32blit/32blit-hardware/README.md

# 32Blit Hardware

This repository includes the schematic and STM32 Cube files for the 32Blit console.
