32blit/32blit-hardware/mechanical/top.stp

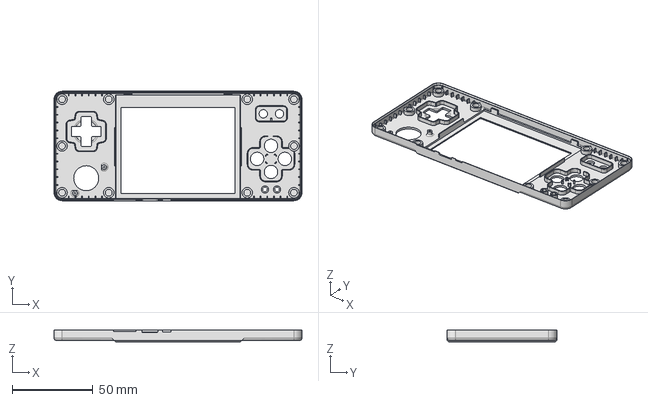
[picture p1: CAD file, 2023-02-23]
mechanical/top.stp
154.0 x 68.0 x 7.20 mm
