32blit/32blit-hardware/mechanical/action-button.stp

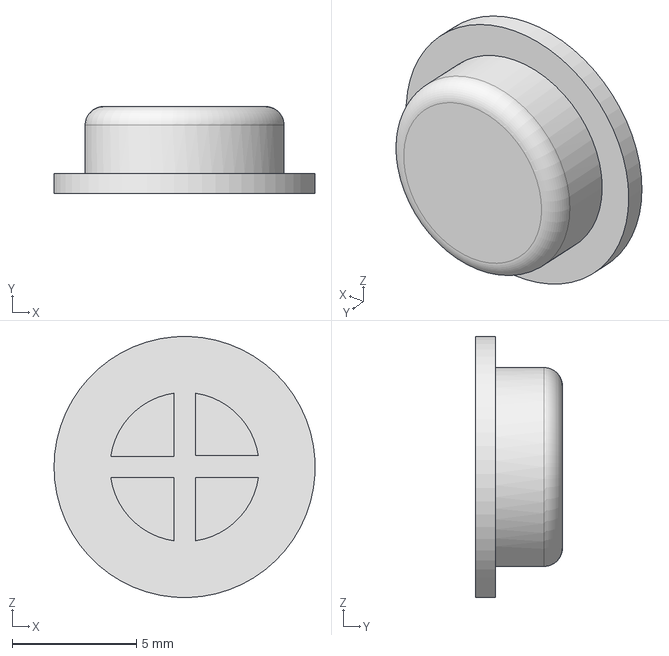
[picture p2: CAD file, 2023-02-23]
mechanical/action-button.stp
10.5 x 3.50 x 10.5 mm
