32blit/32blit-hardware/mechanical/base.stp

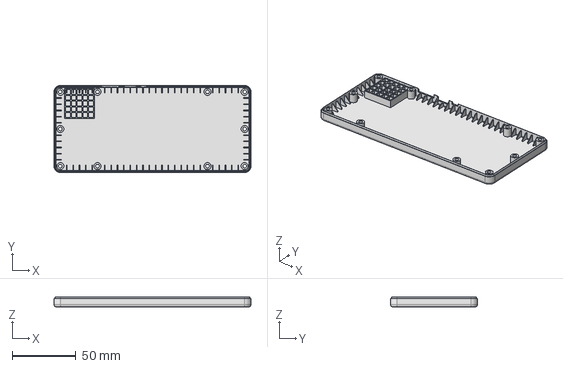
[picture p3: CAD file, 2023-02-23]
mechanical/base.stp
154.0 x 68.0 x 7.75 mm
