32blit/32blit-hardware/mechanical/system-buttons.stp

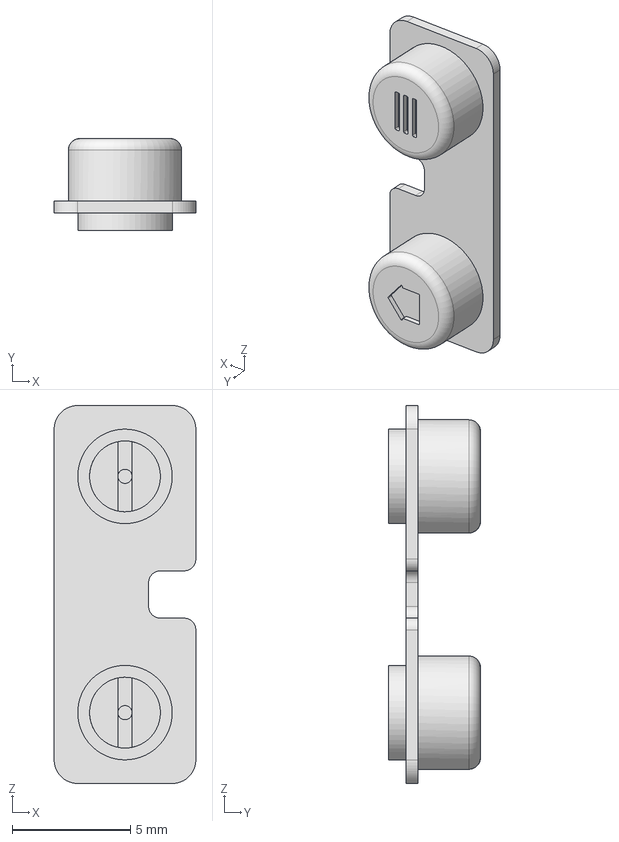
[picture p4: CAD file, 2023-02-23]
mechanical/system-buttons.stp
6.00 x 3.90 x 16.0 mm
