32blit/32blit-hardware/(list of files, cad)

Other CAD files:
mechanical/32blit.iam
mechanical/action-button.ipt
mechanical/base.ipt
mechanical/dpad.ipt
mechanical/pcb.ipt
mechanical/system-buttons.ipt
mechanical/top.ipt
