32blit/32blit-hardware/(threads)

Thread 1 (2023-01-02):

Will the Gerber files be available?

cmcknight, 2023-01-02:
Greetings!

I am wondering if the Gerber files will also be made available for this project.

Gadgetoid, 2023-02-23:
Not a Gerber, unfortunately, but the Eagle board files are now available here: https://github.com/32blit/32blit-hardware/tree/master/pcb

And mechanical design files here: https://github.com/32blit/32blit-hardware/tree/master/mechanical

Though if you're making PCBs somehow and want a case or two, I'm sure that can be arranged.

cmcknight, 2023-02-23:
Thanks Philip,

I’ll share that with my son. He’s buried with mid-terms right now but I’m sure he’ll be interested in cases if he chooses to proceed. :-)

Best regards,

Charles

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
