32blit/32blit-hardware/32blit.pdf

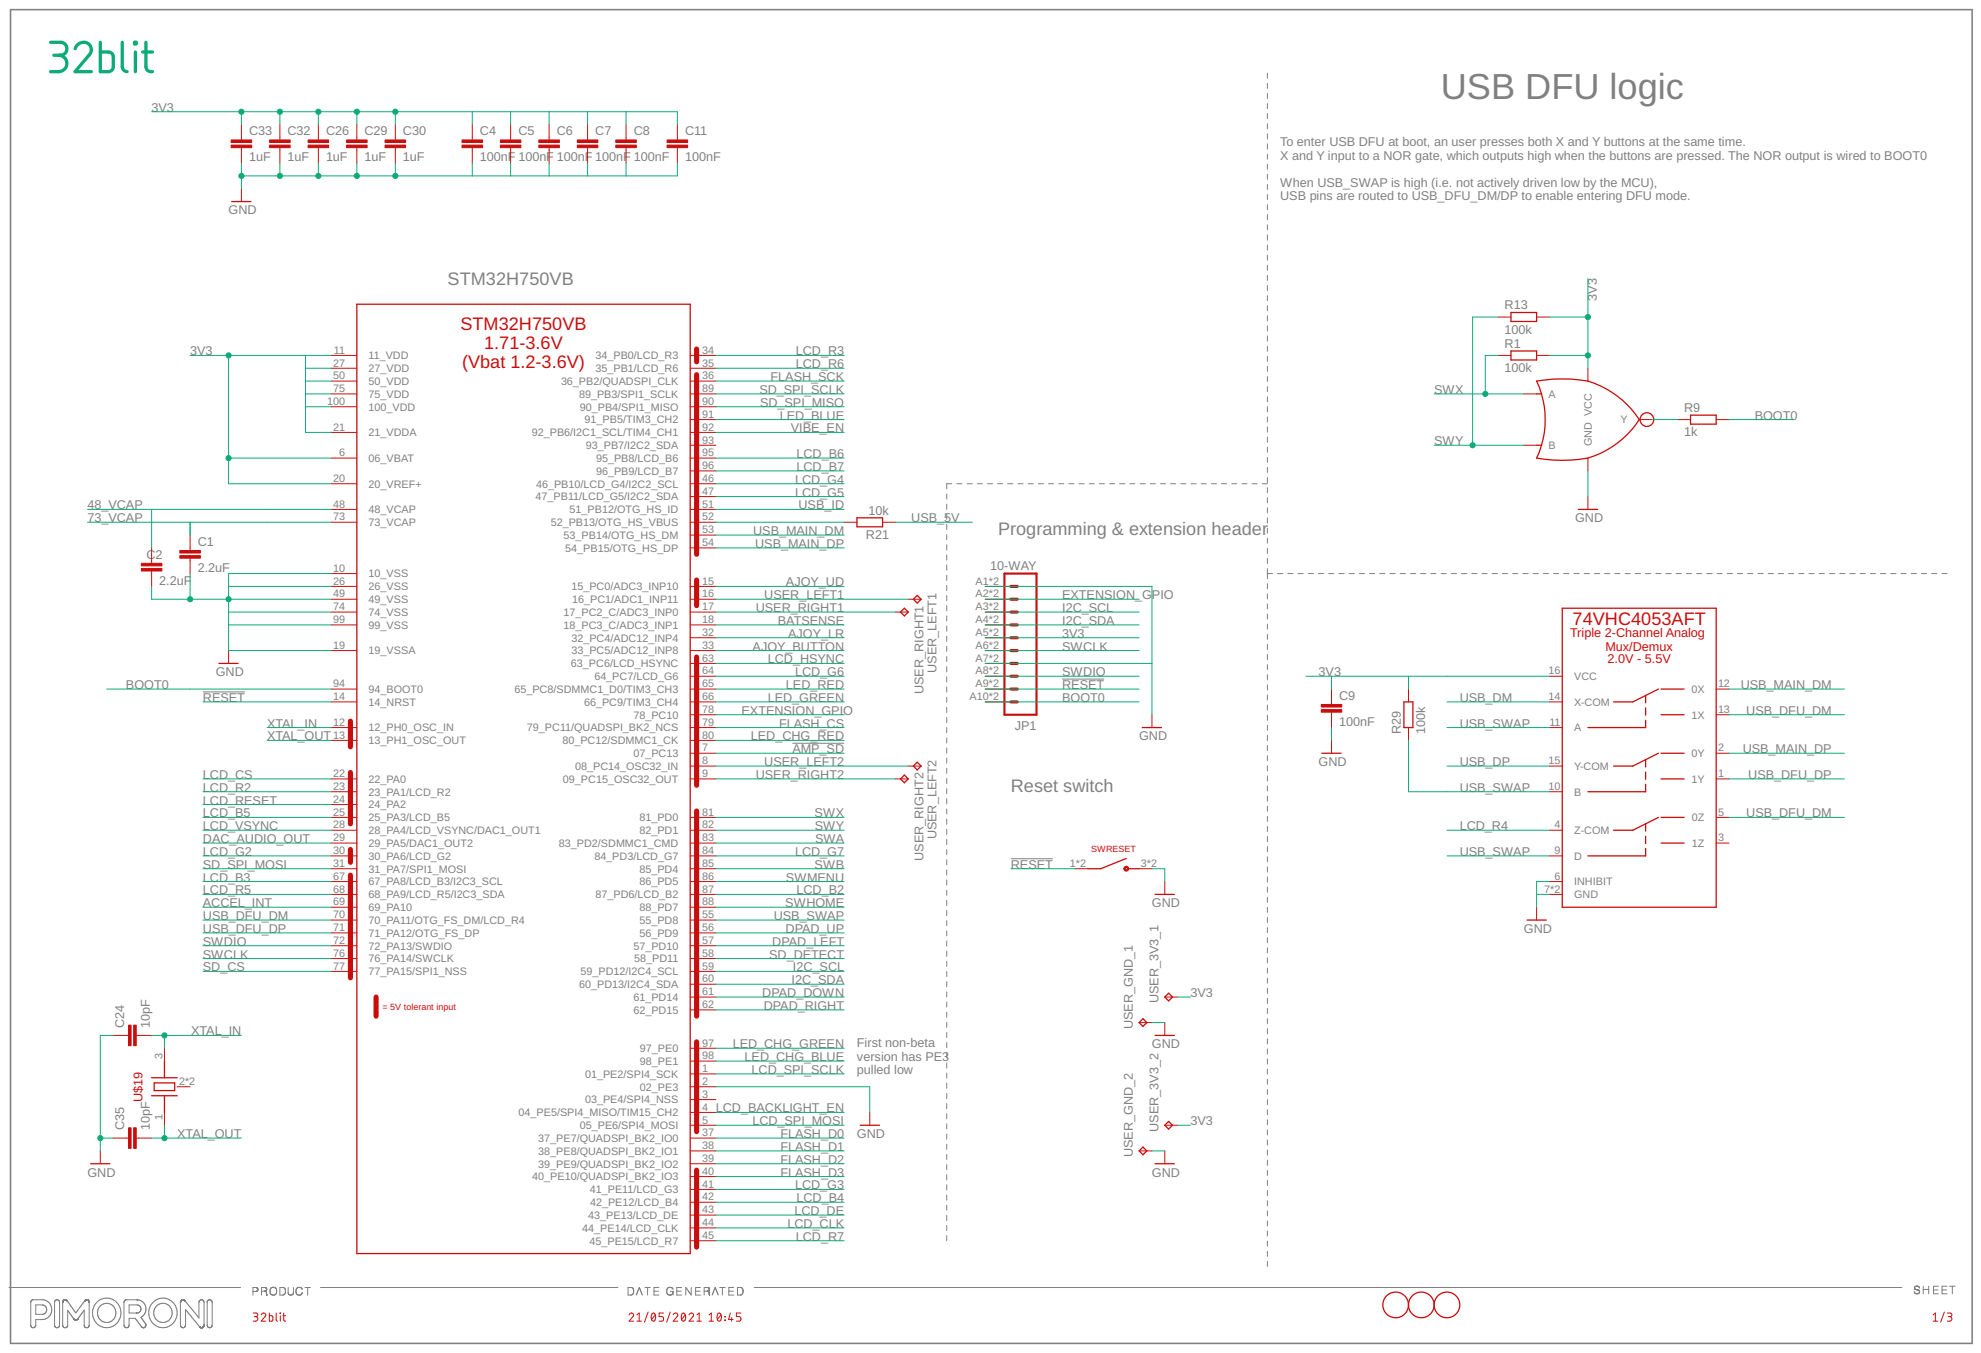
[picture p5: page 1]

To enter USB DFU at boot, an user presses both X and Y buttons at the same time. X and Y input to a NOR gate, which outputs high when the buttons are pressed. The NOR output is wired to BOOT0 When USB_SWAP is high (i.e. not actively driven low by the MCU), USB pins are routed to USB_DFU_DM/DP to enable entering DFU mode. USB DFU logic

74VHC4053AFT
Triple 2-Channel Analog Mux/Demux 2.0V - 5.5V

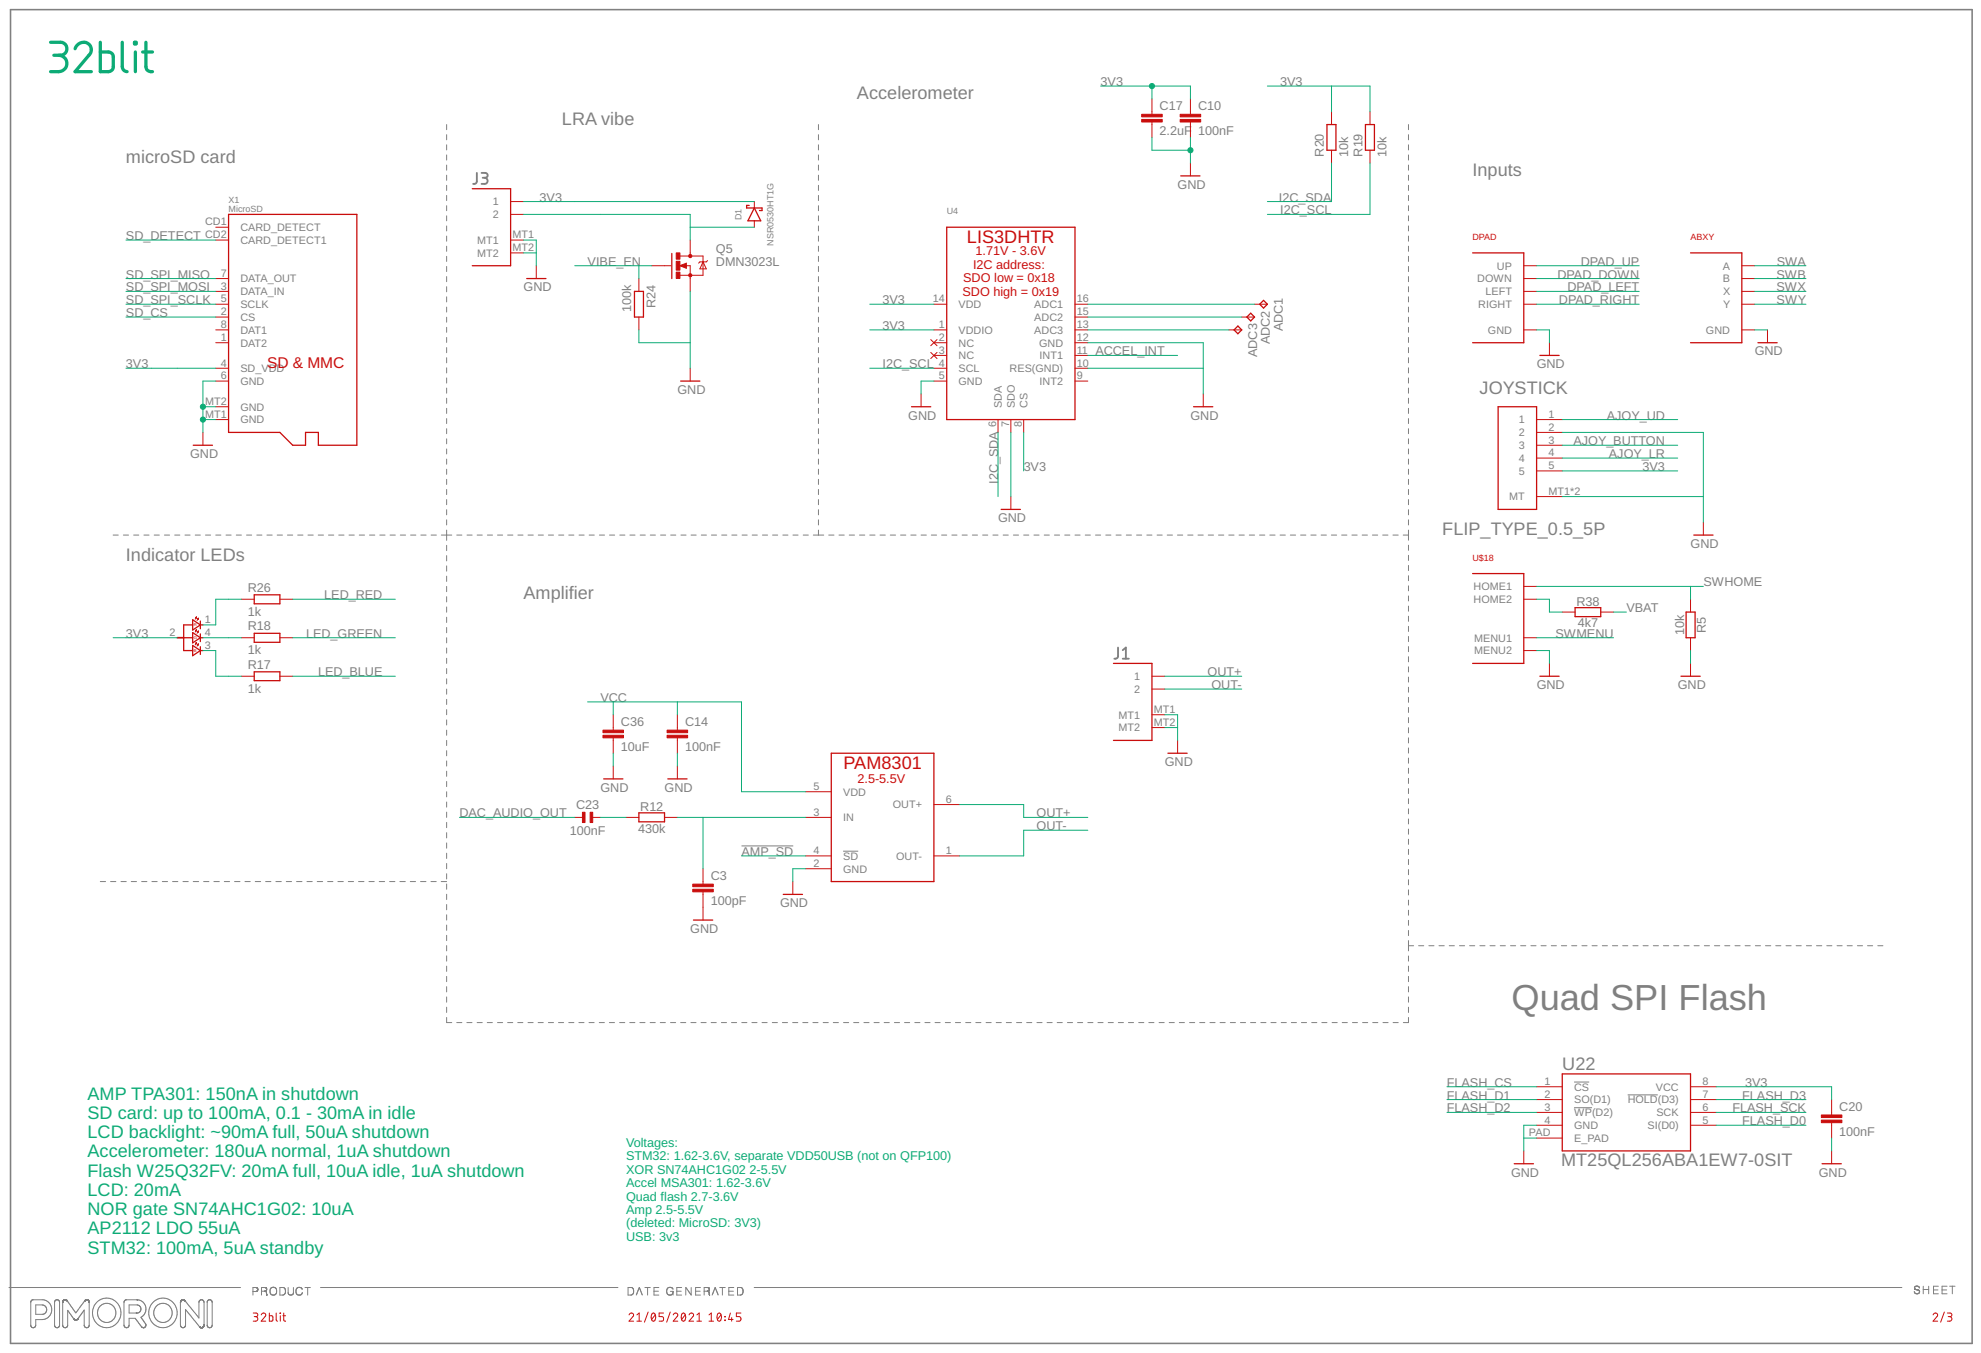
[picture p6: page 2]

LRA vibe microSD card

AMP TPA301: 150nA in shutdown SD card: up to 100mA, 0.1 - 30mA in idle

LCD backlight: ~90mA full, 50uA shutdown Accelerometer: 180uA normal, 1uA shutdown Flash W25Q32FV: 20mA full, 10uA idle, 1uA shutdown

Voltages: STM32: 1.62-3.6V, separate VDD50USB (not on QFP100) XOR SN74AHC1G02 2-5.5V

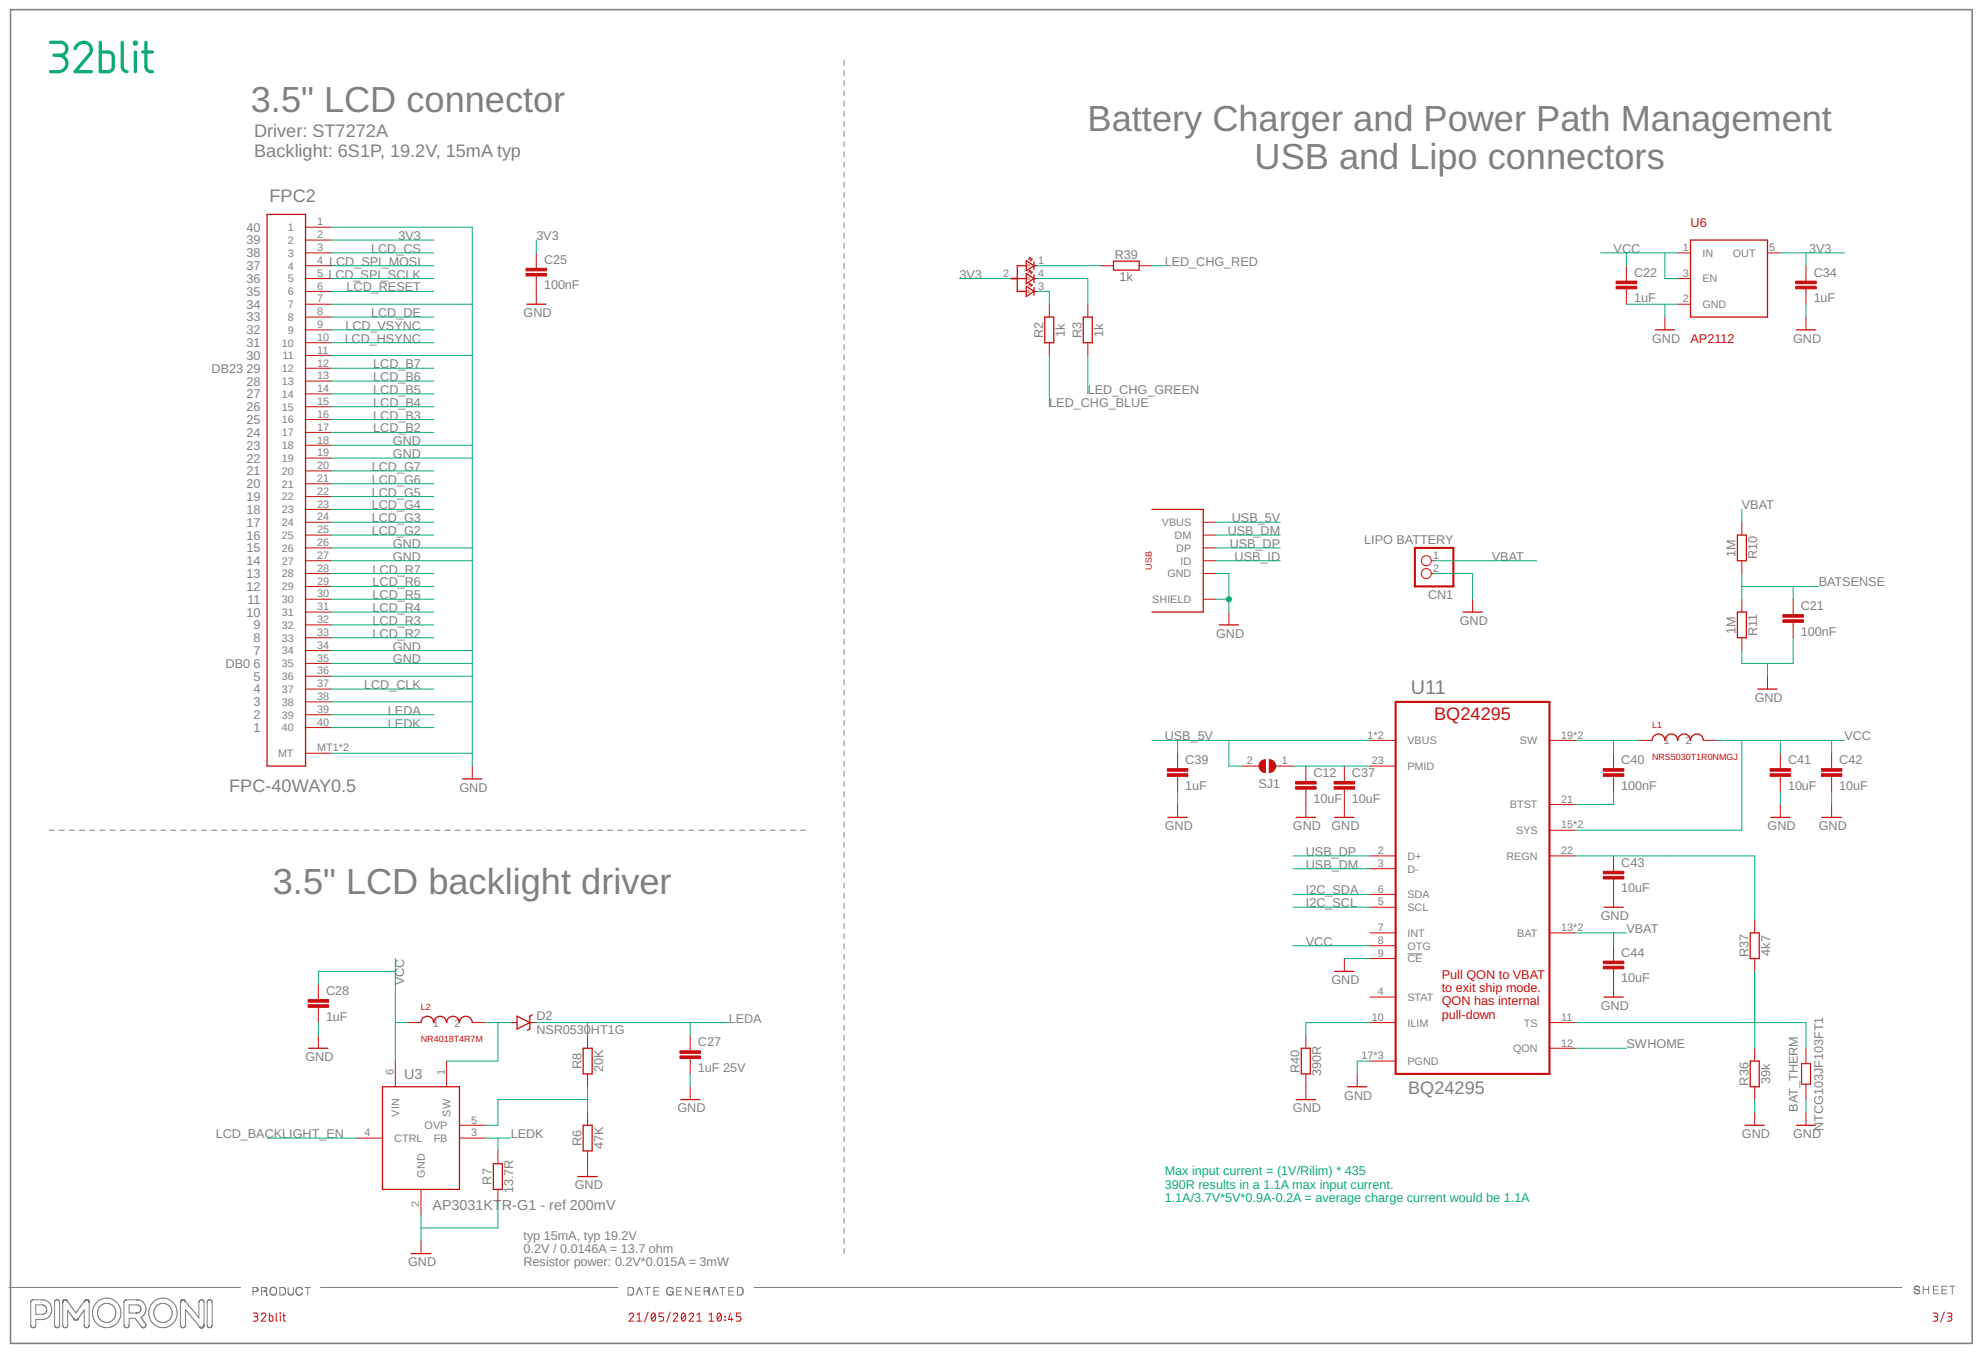
[picture p7: page 3]

Battery Charger and Power Path Management

USB and Lipo connectors

Pull QON to VBAT
to exit ship mode. QON has internal pull-down

Max input current = (1V/Rilim) * 435
390R results in a 1.1A max input current. 1.1A/3.7V*5V*0.9A-0.2A = average charge current would be 1.1A
