32blit/32blit-hardware/pcb/32blit.brd

## EAGLE design pcb/32blit.brd (2023-02-23)

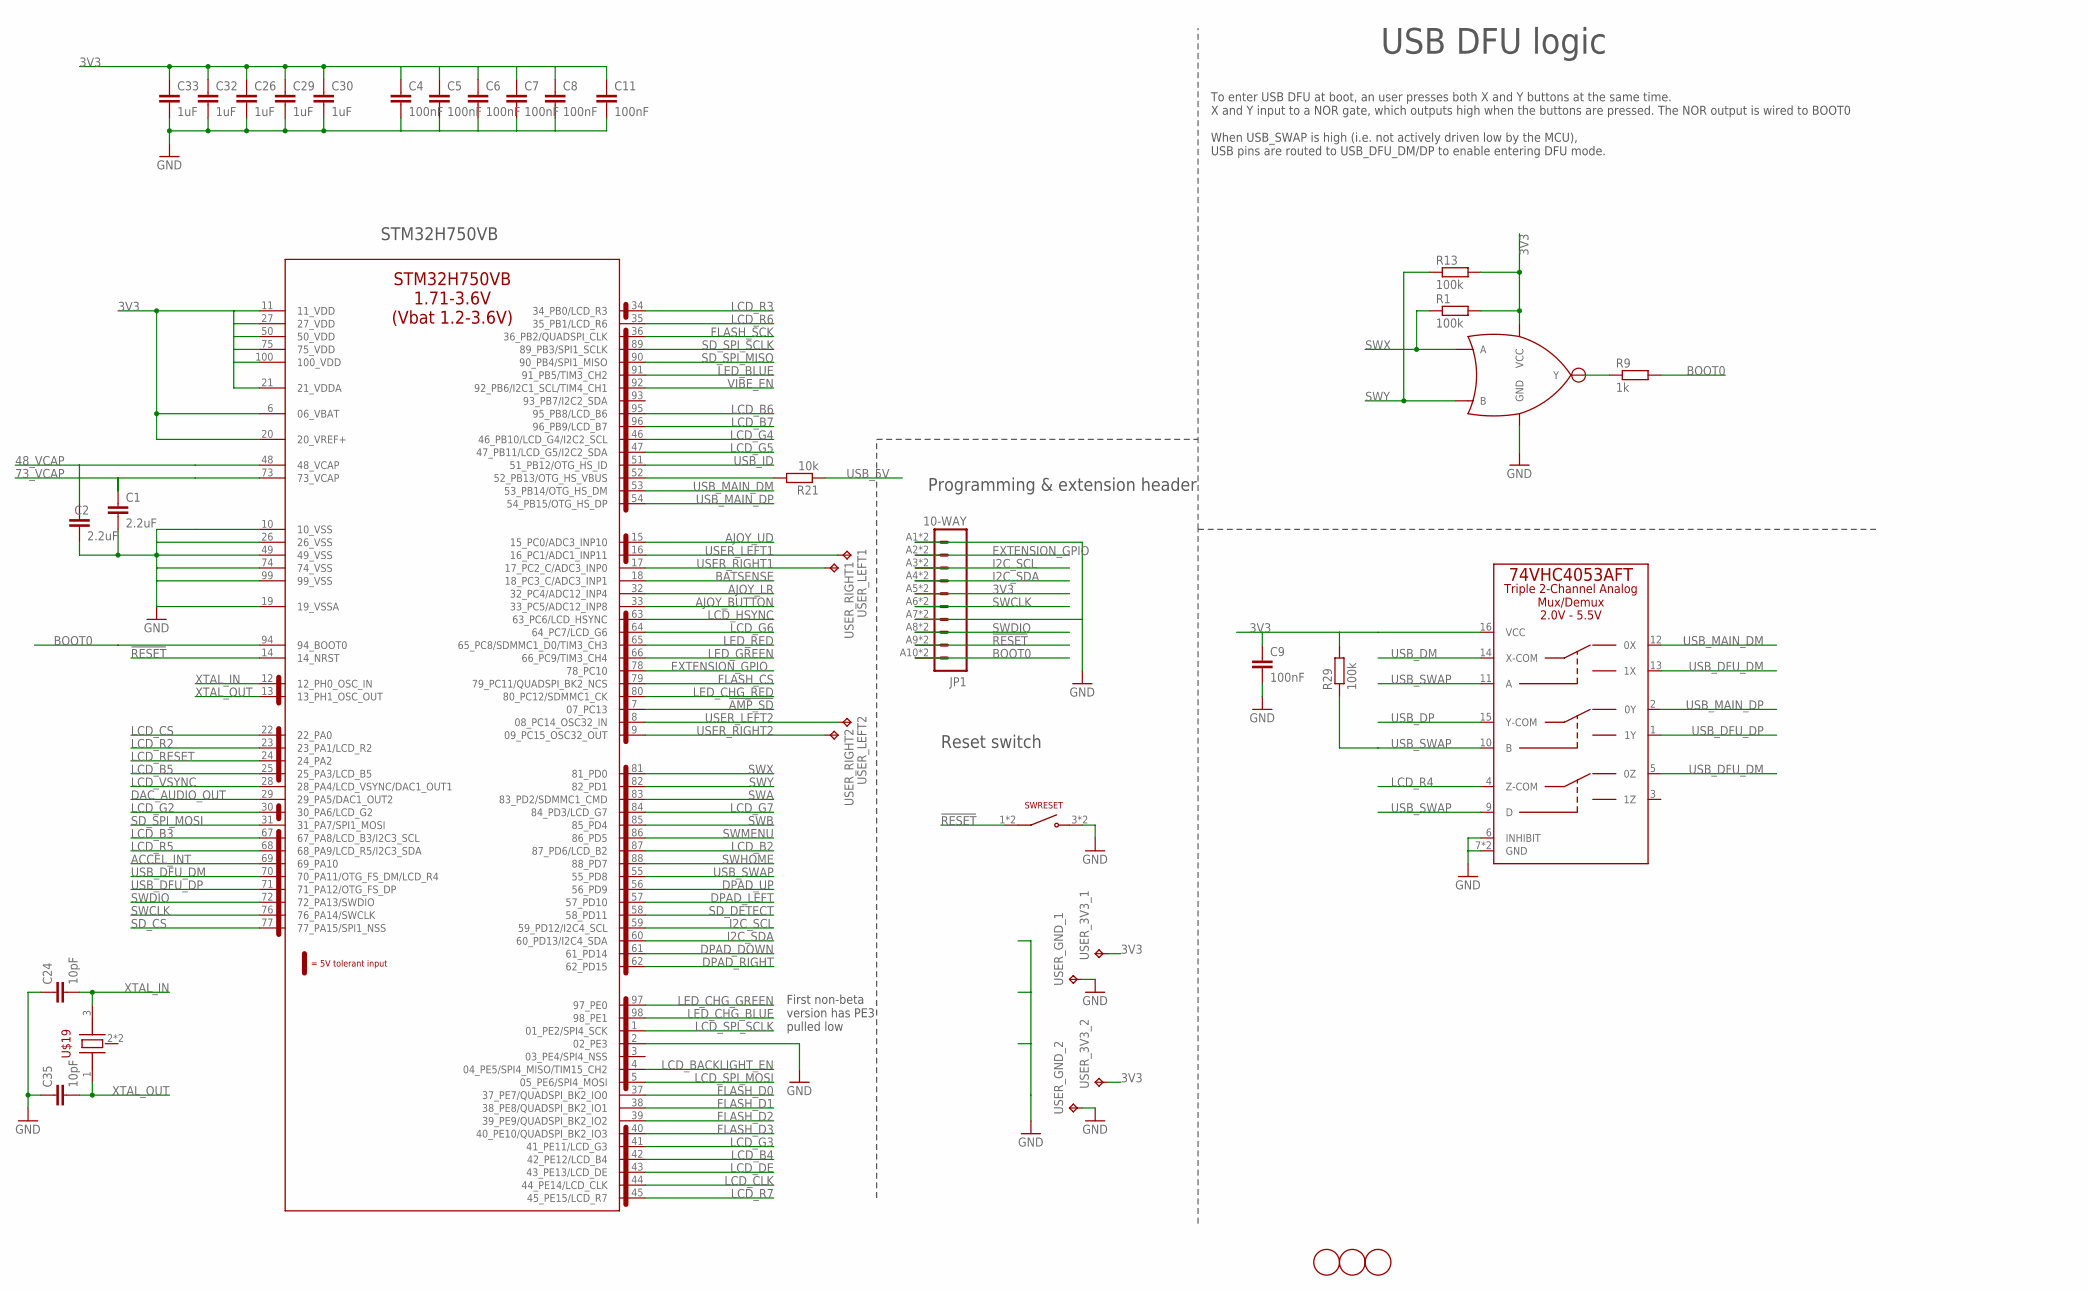
[picture p8: schematic 32blit.sch, sheet 1, MCU]

Parts:
C1, C2: 2.2uF; C0603
C4, C5, C6, C7, C8, C9, C11: 100nF; C0402K
C24, C35: 10pF; C0603K
C26, C29, C30, C32, C33: 1uF; C0603
JP1: 10-WAY; 1X10_FEMALE_SMT_RIGHT_ANGLE
R1, R13, R29: 100k; R0603
R9: 1k; R0603
R21: 10k; R0603
STM32H750: STM32H750VB; LQFP-100
SWRESET: LY-A03-02; TACT_RIGHT_ANGLE_LOW_PROFILE
U1: SN74AHC1G02; SOT-23-5
U8: 74VHC4053AFT; TSSOP-16-TI
U$17, U$22, U$23: FIDUCIAL1MM; FIDUCIAL-1MM
U$19: ABM8G-12.000MHZ-4Y-T3; TSX-3225
USER_3V3_1, USER_3V3_2: TPTP17SQ; TP17SQ
USER_GND_1, USER_GND_2: TPTP17SQ; TP17SQ
USER_LEFT1, USER_LEFT2: TPTP17SQ; TP17SQ
USER_RIGHT1, USER_RIGHT2: TPTP17SQ; TP17SQ

Connections:
3V3: C4.1, C5.1, C6.1, C7.1, C8.1, C9.1, C11.1, C26.1, C29.1, C30.1, C32.1, C33.1, JP1.A5 (5), JP1.B5 (5), R1.2, R13.2, R29.2, STM32H750.6 (06_VBAT), STM32H750.11 (11_VDD), STM32H750.20 (20_VREF+), STM32H750.21 (21_VDDA), STM32H750.27 (27_VDD), STM32H750.50 (50_VDD), STM32H750.75 (75_VDD), STM32H750.100 (100_VDD), U1.5 (VCC), U8.16 (VCC), USER_3V3_1.TP, USER_3V3_2.TP; also elsewhere on the board
48_VCAP: C2.1, STM32H750.48 (48_VCAP)
73_VCAP: C1.1, STM32H750.73 (73_VCAP)
!AMP_SD: STM32H750.7 (07_PC13); also elsewhere on the board
!RESET: JP1.A9 (9), JP1.B9 (9), STM32H750.14 (14_NRST), SWRESET.1, SWRESET.2 (1)
ACCEL_INT: STM32H750.69 (69_PA10); also elsewhere on the board
AJOY_BUTTON: STM32H750.33 (33_PC5/ADC12_INP8); also elsewhere on the board
AJOY_LR: STM32H750.32 (32_PC4/ADC12_INP4); also elsewhere on the board
AJOY_UD: STM32H750.15 (15_PC0/ADC3_INP10); also elsewhere on the board
BATSENSE: STM32H750.18 (18_PC3_C/ADC3_INP1); also elsewhere on the board
BOOT0: JP1.A10 (10), JP1.B10 (10), R9.2, STM32H750.94 (94_BOOT0)
DAC_AUDIO_OUT: STM32H750.29 (29_PA5/DAC1_OUT2); also elsewhere on the board
DPAD_DOWN: STM32H750.61 (61_PD14); also elsewhere on the board
DPAD_LEFT: STM32H750.57 (57_PD10); also elsewhere on the board
DPAD_RIGHT: STM32H750.62 (62_PD15); also elsewhere on the board
DPAD_UP: STM32H750.56 (56_PD9); also elsewhere on the board
EXTENSION_GPIO: JP1.A2 (2), JP1.B2 (2), STM32H750.78 (78_PC10)
FLASH_CS: STM32H750.79 (79_PC11/QUADSPI_BK2_NCS); also elsewhere on the board
FLASH_D0: STM32H750.37 (37_PE7/QUADSPI_BK2_IO0); also elsewhere on the board
FLASH_D1: STM32H750.38 (38_PE8/QUADSPI_BK2_IO1); also elsewhere on the board
FLASH_D2: STM32H750.39 (39_PE9/QUADSPI_BK2_IO2); also elsewhere on the board
FLASH_D3: STM32H750.40 (40_PE10/QUADSPI_BK2_IO3); also elsewhere on the board
FLASH_SCK: STM32H750.36 (36_PB2/QUADSPI_CLK); also elsewhere on the board
GND: C1.2, C2.2, C4.2, C5.2, C6.2, C7.2, C8.2, C9.2, C11.2, C24.1, C26.2, C29.2, C30.2, C32.2, C33.2, C35.1, JP1.A1 (1), JP1.A7 (7), JP1.B1 (1), JP1.B7 (7), STM32H750.2 (02_PE3), STM32H750.10 (10_VSS), STM32H750.19 (19_VSSA), STM32H750.26 (26_VSS), STM32H750.49 (49_VSS), STM32H750.74 (74_VSS), STM32H750.99 (99_VSS), SWRESET.3 (2), SWRESET.4 (2), U1.3 (GND), U8.6 (INHIBIT), U8.7 (GND), U8.8 (GND), USER_GND_1.TP, USER_GND_2.TP; also elsewhere on the board
I2C_SCL: JP1.A3 (3), JP1.B3 (3), STM32H750.59 (59_PD12/I2C4_SCL); also elsewhere on the board
I2C_SDA: JP1.A4 (4), JP1.B4 (4), STM32H750.60 (60_PD13/I2C4_SDA); also elsewhere on the board
LCD_B2: STM32H750.87 (87_PD6/LCD_B2); also elsewhere on the board
LCD_B3: STM32H750.67 (67_PA8/LCD_B3/I2C3_SCL); also elsewhere on the board
LCD_B4: STM32H750.42 (42_PE12/LCD_B4); also elsewhere on the board
LCD_B5: STM32H750.25 (25_PA3/LCD_B5); also elsewhere on the board
LCD_B6: STM32H750.95 (95_PB8/LCD_B6); also elsewhere on the board
LCD_B7: STM32H750.96 (96_PB9/LCD_B7); also elsewhere on the board
LCD_BACKLIGHT_EN: STM32H750.4 (04_PE5/SPI4_MISO/TIM15_CH2); also elsewhere on the board
LCD_CLK: STM32H750.44 (44_PE14/LCD_CLK); also elsewhere on the board
LCD_CS: STM32H750.22 (22_PA0); also elsewhere on the board
LCD_DE: STM32H750.43 (43_PE13/LCD_DE); also elsewhere on the board
LCD_G2: STM32H750.30 (30_PA6/LCD_G2); also elsewhere on the board
LCD_G3: STM32H750.41 (41_PE11/LCD_G3); also elsewhere on the board
LCD_G4: STM32H750.46 (46_PB10/LCD_G4/I2C2_SCL); also elsewhere on the board
LCD_G5: STM32H750.47 (47_PB11/LCD_G5/I2C2_SDA); also elsewhere on the board
LCD_G6: STM32H750.64 (64_PC7/LCD_G6); also elsewhere on the board
LCD_G7: STM32H750.84 (84_PD3/LCD_G7); also elsewhere on the board
LCD_HSYNC: STM32H750.63 (63_PC6/LCD_HSYNC); also elsewhere on the board
LCD_R2: STM32H750.23 (23_PA1/LCD_R2); also elsewhere on the board
LCD_R3: STM32H750.34 (34_PB0/LCD_R3); also elsewhere on the board
LCD_R4: U8.4 (Z-COM); also elsewhere on the board
LCD_R5: STM32H750.68 (68_PA9/LCD_R5/I2C3_SDA); also elsewhere on the board
LCD_R6: STM32H750.35 (35_PB1/LCD_R6); also elsewhere on the board
LCD_R7: STM32H750.45 (45_PE15/LCD_R7); also elsewhere on the board
LCD_RESET: STM32H750.24 (24_PA2); also elsewhere on the board
LCD_SPI_MOSI: STM32H750.5 (05_PE6/SPI4_MOSI); also elsewhere on the board
LCD_SPI_SCLK: STM32H750.1 (01_PE2/SPI4_SCK); also elsewhere on the board
LCD_VSYNC: STM32H750.28 (28_PA4/LCD_VSYNC/DAC1_OUT1); also elsewhere on the board
LED_BLUE: STM32H750.91 (91_PB5/TIM3_CH2); also elsewhere on the board
LED_CHG_BLUE: STM32H750.98 (98_PE1); also elsewhere on the board
LED_CHG_GREEN: STM32H750.97 (97_PE0); also elsewhere on the board
LED_CHG_RED: STM32H750.80 (80_PC12/SDMMC1_CK); also elsewhere on the board
LED_GREEN: STM32H750.66 (66_PC9/TIM3_CH4); also elsewhere on the board
LED_RED: STM32H750.65 (65_PC8/SDMMC1_D0/TIM3_CH3); also elsewhere on the board
unnamed: R9.1, U1.4 (Y)
unnamed: R21.2, STM32H750.52 (52_PB13/OTG_HS_VBUS)
SD_CS: STM32H750.77 (77_PA15/SPI1_NSS); also elsewhere on the board
SD_DETECT: STM32H750.58 (58_PD11); also elsewhere on the board
SD_SPI_MISO: STM32H750.90 (90_PB4/SPI1_MISO); also elsewhere on the board
SD_SPI_MOSI: STM32H750.31 (31_PA7/SPI1_MOSI); also elsewhere on the board
SD_SPI_SCLK: STM32H750.89 (89_PB3/SPI1_SCLK); also elsewhere on the board
SWA: STM32H750.83 (83_PD2/SDMMC1_CMD); also elsewhere on the board
SWB: STM32H750.85 (85_PD4); also elsewhere on the board
SWCLK: JP1.A6 (6), JP1.B6 (6), STM32H750.76 (76_PA14/SWCLK)
SWDIO: JP1.A8 (8), JP1.B8 (8), STM32H750.72 (72_PA13/SWDIO)
SWHOME: STM32H750.88 (88_PD7); also elsewhere on the board
SWMENU: STM32H750.86 (86_PD5); also elsewhere on the board
SWX: R1.1, STM32H750.81 (81_PD0), U1.1 (A); also elsewhere on the board
SWY: R13.1, STM32H750.82 (82_PD1), U1.2 (B); also elsewhere on the board
USB_5V: R21.1; also elsewhere on the board
USB_DFU_DM: STM32H750.70 (70_PA11/OTG_FS_DM/LCD_R4), U8.5 (0Z), U8.13 (1X)
USB_DFU_DP: STM32H750.71 (71_PA12/OTG_FS_DP), U8.1 (1Y)
USB_DM: U8.14 (X-COM); also elsewhere on the board
USB_DP: U8.15 (Y-COM); also elsewhere on the board
USB_ID: STM32H750.51 (51_PB12/OTG_HS_ID); also elsewhere on the board
USB_MAIN_DM: STM32H750.53 (53_PB14/OTG_HS_DM), U8.12 (0X)
USB_MAIN_DP: STM32H750.54 (54_PB15/OTG_HS_DP), U8.2 (0Y)
USB_SWAP: R29.1, STM32H750.55 (55_PD8), U8.9 (D), U8.10 (B), U8.11 (A)
USER_LEFT1: STM32H750.16 (16_PC1/ADC1_INP11), USER_LEFT1.TP
USER_LEFT2: STM32H750.8 (08_PC14_OSC32_IN), USER_LEFT2.TP
USER_RIGHT1: STM32H750.17 (17_PC2_C/ADC3_INP0), USER_RIGHT1.TP
USER_RIGHT2: STM32H750.9 (09_PC15_OSC32_OUT), USER_RIGHT2.TP
VIBE_EN: STM32H750.92 (92_PB6/I2C1_SCL/TIM4_CH1); also elsewhere on the board
XTAL_IN: C24.2, STM32H750.12 (12_PH0_OSC_IN), U$19.3 (2)
XTAL_OUT: C35.2, STM32H750.13 (13_PH1_OSC_OUT), U$19.1

Notes on the sheet:
STM32H750VB
Programming & extension header
Reset switch
To enter USB DFU at boot, an user presses both X and Y buttons at the same time. X and Y input to a NOR gate, which outputs high when the buttons are pressed. The NOR output is wired to BOOT0 When USB_SWAP is high (i.e. not actively driven low by the MCU), USB pins are routed to USB_DFU_DM/DP to en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
USB DFU logic
First non-beta version has PE3 pulled low

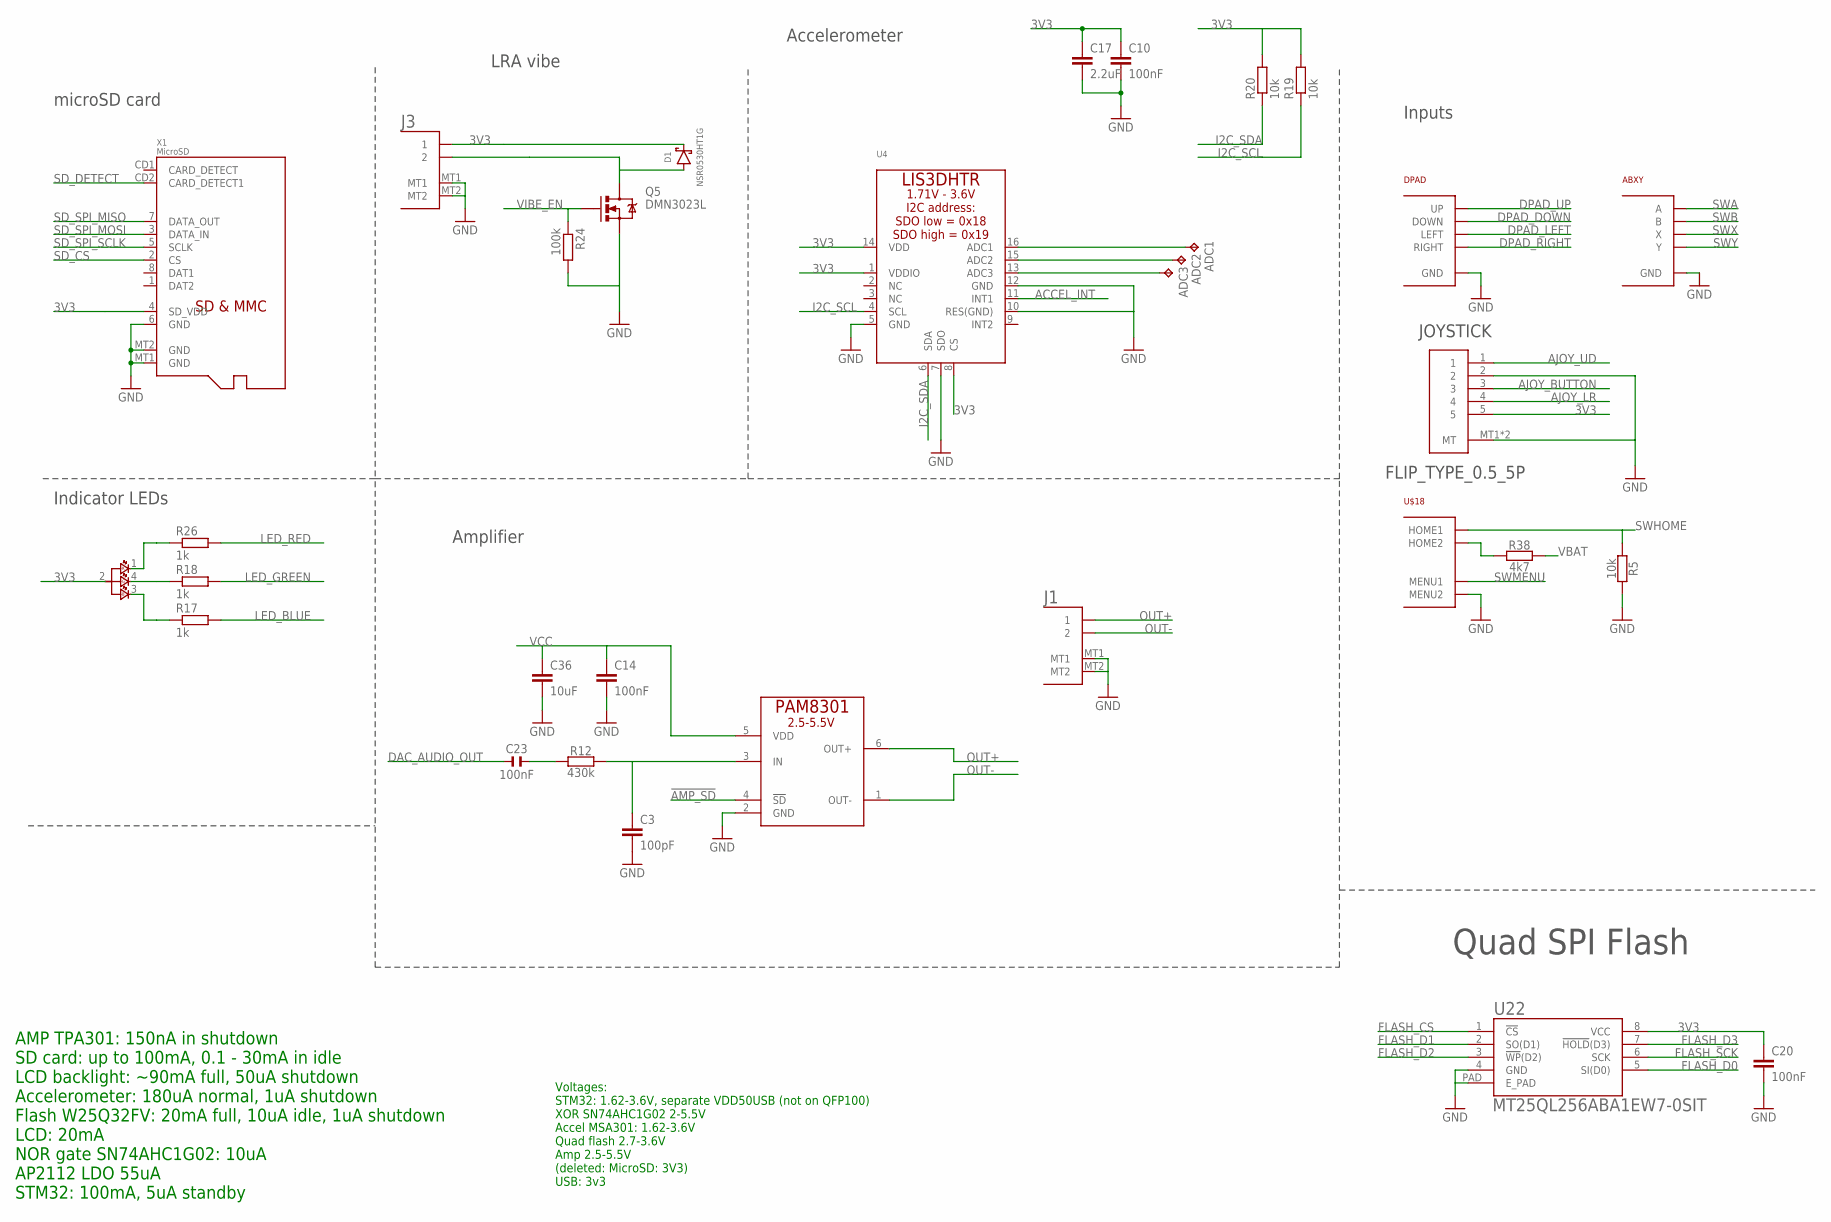
[picture p9: schematic 32blit.sch, sheet 2, Peripherals]

Parts:
ABXY: ABXY
ADC1, ADC2, ADC3: TPTP17SQ; TP17SQ
C3: 100pF; C0603
C10, C14, C20: 100nF; C0402K
C17: 2.2uF; C0603
C23: 100nF; 0402
C36: 10uF; C0805
D1: NSR0530HT1G; SOD-323
DPAD: DPAD
J1: 1X02PICOBLADE; PICOBLADE_1.25MM_2P
J3: 1X02JST_SH; JST_SH_1.0MM_2P
JOYSTICK: FLIP_TYPE_0.5_5P; FPC-0.5MM-05WAY
Q5: DMN3023L; SOT23
R5, R19, R20: 10k; R0603
R12: 430k; R0603
R17, R18, R26: 1k; R0603
R24: 100k; R0603
R38: 4k7; R0603
RGB2: LED_RGB_4P6028_REVERSE; LED-6028_REVERSE_RGB
U4: ACCEL_LIS3DHTR; LGA16_3X3MM
U5: PAM8301; SOT-23-6
U22: MT25QL256ABA1EW7-0SIT; DFN-8_6X5MM
U$18: HOME-MENU; MENU-HOME
X1: MicroSD; MICROSD

Connections:
3V3: C10.1, C17.1, C20.1, D1.C, J3.1, JOYSTICK.5, R19.2, R20.2, RGB2.2 (A), U4.1 (VDDIO), U4.8 (CS), U4.14 (VDD), U22.8 (VCC), X1.4 (SD_VDD); also elsewhere on the board
!AMP_SD: U5.4 (!SD); also elsewhere on the board
ACCEL_INT: U4.11 (INT1); also elsewhere on the board
AJOY_BUTTON: JOYSTICK.3; also elsewhere on the board
AJOY_LR: JOYSTICK.4; also elsewhere on the board
AJOY_UD: JOYSTICK.1; also elsewhere on the board
DAC_AUDIO_OUT: C23.2; also elsewhere on the board
DPAD_DOWN: DPAD.DOWN; also elsewhere on the board
DPAD_LEFT: DPAD.LEFT; also elsewhere on the board
DPAD_RIGHT: DPAD.RIGHT; also elsewhere on the board
DPAD_UP: DPAD.UP; also elsewhere on the board
FLASH_CS: U22.1 (!CS); also elsewhere on the board
FLASH_D0: U22.5 (SI(D0)); also elsewhere on the board
FLASH_D1: U22.2 (SO(D1)); also elsewhere on the board
FLASH_D2: U22.3 (!WP!(D2)); also elsewhere on the board
FLASH_D3: U22.7 (!HOLD!(D3)); also elsewhere on the board
FLASH_SCK: U22.6 (SCK); also elsewhere on the board
GND: ABXY.GND1 (GND), ABXY.GND2 (GND), ABXY.GND3 (GND), ABXY.GND4 (GND), C3.2, C10.2, C14.2, C17.2, C20.2, C36.2, DPAD.GND1 (GND), DPAD.GND2 (GND), DPAD.GND3 (GND), DPAD.GND4 (GND), J1.MT1, J1.MT2, J3.MT1, J3.MT2, JOYSTICK.2, JOYSTICK.MT1 (MT), JOYSTICK.MT2 (MT), Q5.2 (S), R5.2, R24.2, U4.5 (GND), U4.7 (SDO), U4.10 (RES(GND)), U4.12 (GND), U5.2 (GND), U22.4 (GND), U22.PAD (E_PAD), U$18.GND3 (MENU2), X1.6 (GND), X1.MT1 (GND), X1.MT2 (GND); also elsewhere on the board
I2C_SCL: R19.1, U4.4 (SCL); also elsewhere on the board
I2C_SDA: R20.1, U4.6 (SDA); also elsewhere on the board
LED_BLUE: R17.2; also elsewhere on the board
LED_GREEN: R18.2; also elsewhere on the board
LED_RED: R26.2; also elsewhere on the board
unnamed: ADC3.TP, U4.13 (ADC3)
unnamed: C3.1, R12.2, U5.3 (IN)
unnamed: R18.1, RGB2.4 (GC)
unnamed: R17.1, RGB2.3 (BC)
unnamed: C23.1, R12.1
unnamed: ADC2.TP, U4.15 (ADC2)
unnamed: ADC1.TP, U4.16 (ADC1)
unnamed: D1.A, J3.2, Q5.3 (D)
unnamed: R26.1, RGB2.1 (RC)
unnamed: R38.1, U$18.GND4 (HOME2)
OUT+: J1.1, U5.6 (OUT+)
OUT-: J1.2, U5.1 (OUT-)
SD_CS: X1.2 (CS); also elsewhere on the board
SD_DETECT: X1.CD2 (CARD_DETECT1); also elsewhere on the board
SD_SPI_MISO: X1.7 (DATA_OUT); also elsewhere on the board
SD_SPI_MOSI: X1.3 (DATA_IN); also elsewhere on the board
SD_SPI_SCLK: X1.5 (SCLK); also elsewhere on the board
SWA: ABXY.A; also elsewhere on the board
SWB: ABXY.B; also elsewhere on the board
SWHOME: R5.1, U$18.HOME (HOME1); also elsewhere on the board
SWMENU: U$18.MENU (MENU1); also elsewhere on the board
SWX: ABXY.X; also elsewhere on the board
SWY: ABXY.Y; also elsewhere on the board
VBAT: R38.2; also elsewhere on the board
VCC: C14.1, C36.1, U5.5 (VDD); also elsewhere on the board
VIBE_EN: Q5.1 (G), R24.1; also elsewhere on the board

Notes on the sheet:
Quad SPI Flash
Accelerometer
Inputs
Indicator LEDs
Amplifier
AMP TPA301: 150nA in shutdown SD card: up to 100mA, 0.1 - 30mA in idle LCD backlight: ~90mA full, 50uA shutdown Accelerometer: 180uA normal, 1uA shutdown Flash W25Q32FV: 20mA full, 10uA idle, 1uA shutdown LCD: 20mA NOR gate SN74AHC1G02: 10uA AP2112 LDO 55uA STM32: 100mA, 5uA standby
Voltages: STM32: 1.62-3.6V, separate VDD50USB (not on QFP100) XOR SN74AHC1G02 2-5.5V Accel MSA301: 1.62-3.6V Quad flash 2.7-3.6V Amp 2.5-5.5V (deleted: MicroSD: 3V3) USB: 3v3
LRA vibe
microSD card

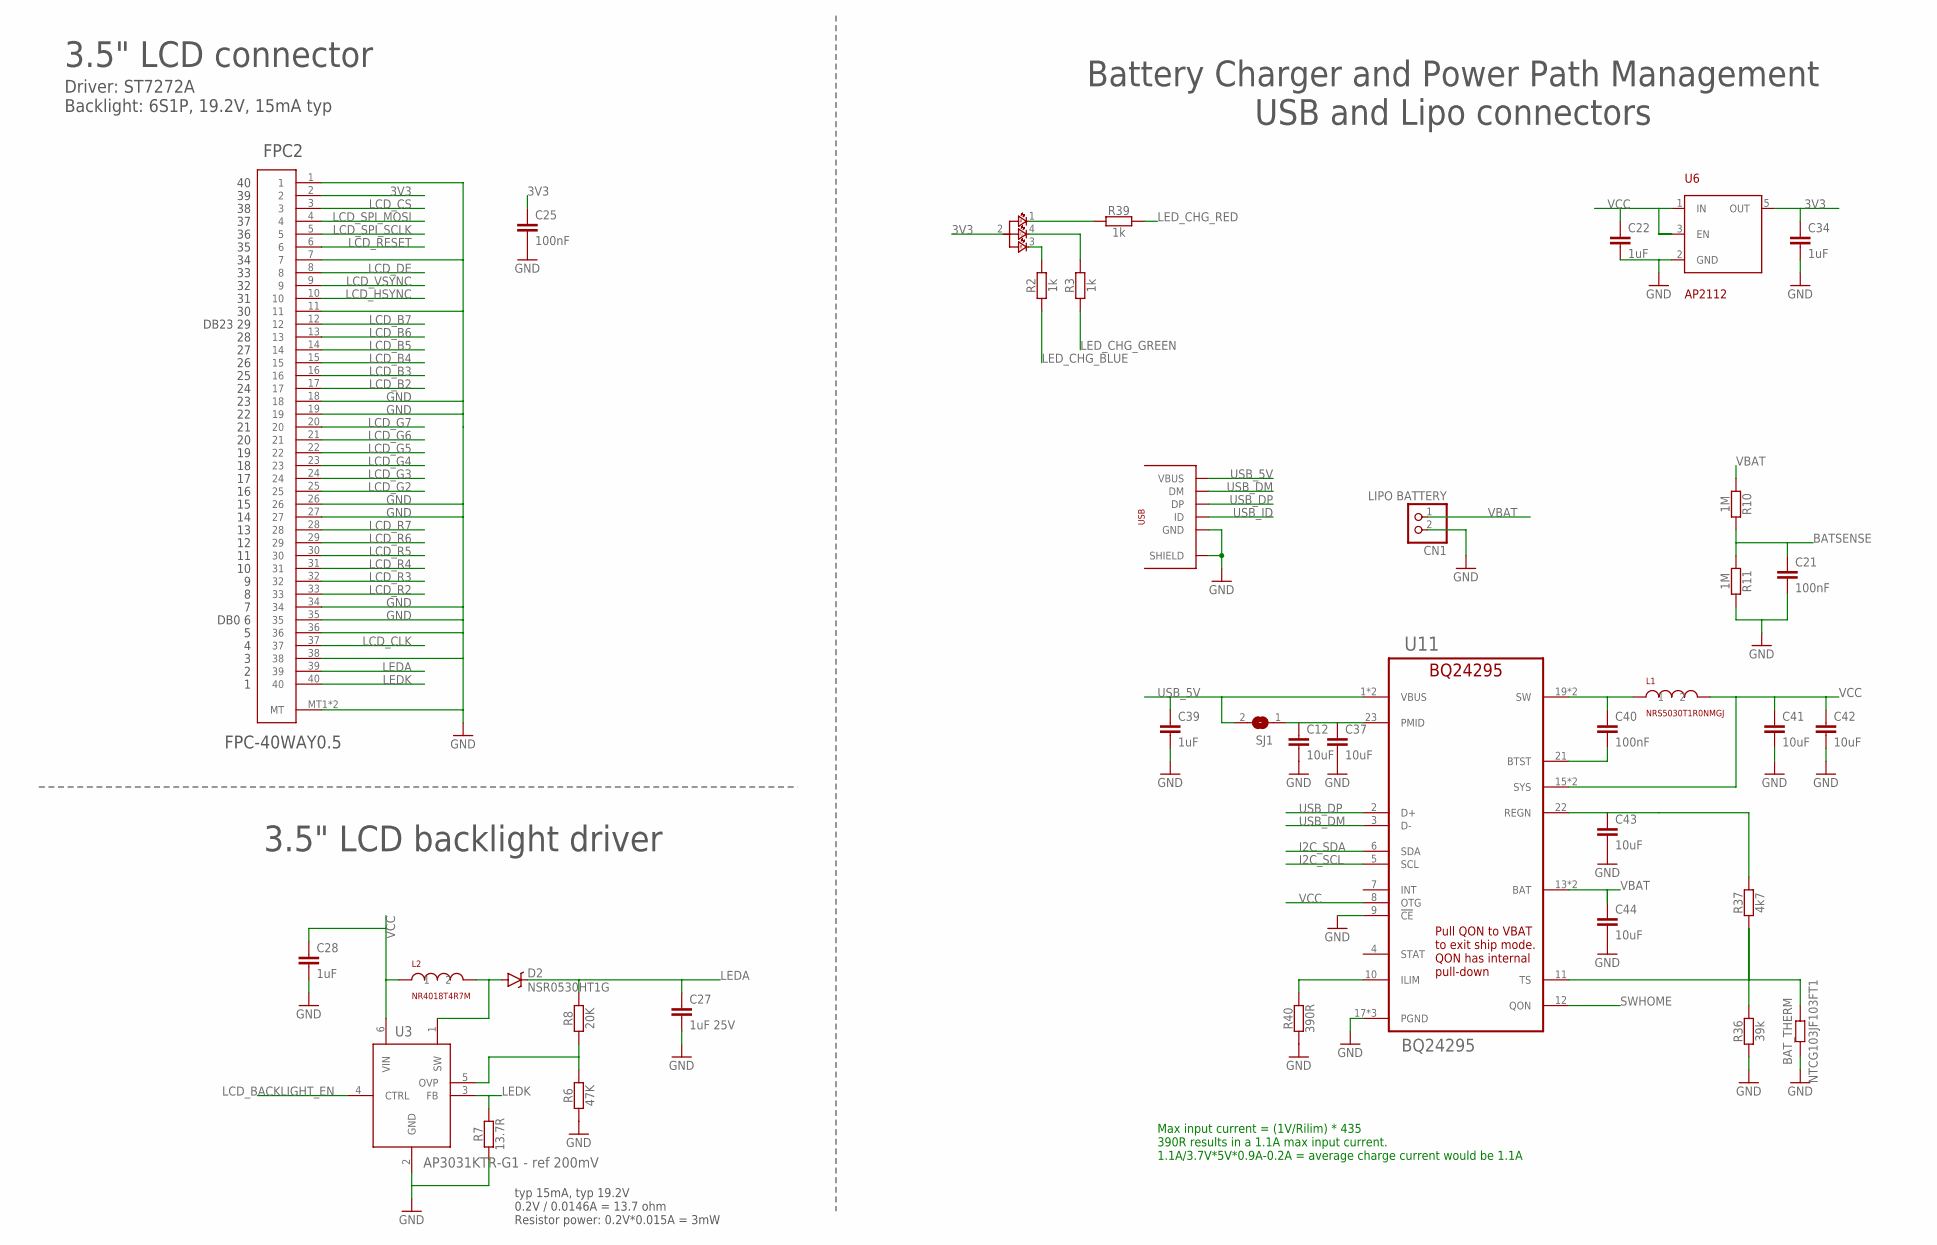
[picture p10: schematic 32blit.sch, sheet 3, LCDs and Power]

Parts:
BAT_THERM: NTCG103JF103FT1; 0402@1
C12, C37, C41, C42, C43, C44: 10uF; C0805
C21, C25, C40: 100nF; C0402K
C22, C28, C34, C39: 1uF; C0603
C27: 1uF 25V; C0603
CN1: LIPO BATTERY; JST-PH-2-SMT-RA
D2: NSR0530HT1G
FPC2: FPC-40WAY0.5; FPC-0.5MM-40WAY
L1: NRS5030T1R0NMGJ; NRS5030
L2: NR4018T4R7M; NR4018
R2, R3, R39: 1k; R0603
R6: 47K; R0603
R7: 13.7R; R0603
R8: 20K; R0603
R10, R11: 1M; R0603
R36: 39k; R0603
R37: 4k7; R0603
R40: 390R; R0603
RGB1: LED_RGB_4P6028_REVERSE; LED-6028_REVERSE_RGB
SJ1: SOLDERJUMPER; SOLDERJUMPER_ARROW_NOPASTE
U3: AP3031KTR-G1 - ref 200mV; SOT23-6L
U6: AP2112; SOT-23-5
U11: BQ24295; QFN50P400X400X100-25N
U$3: FCI 10118193-0001LF; MICROB-USB

Connections:
3V3: C25.1, C34.1, FPC2.2, RGB1.2 (A), U6.5 (OUT); also elsewhere on the board
BATSENSE: C21.1, R10.2, R11.1; also elsewhere on the board
GND: BAT_THERM.1, C12.2, C21.2, C22.2, C25.2, C27.2, C28.2, C34.2, C37.2, C39.2, C41.2, C42.2, C43.2, C44.2, CN1.2 (1), FPC2.1, FPC2.7, FPC2.11, FPC2.18, FPC2.19, FPC2.26, FPC2.27, FPC2.34, FPC2.35, FPC2.36, FPC2.38, FPC2.MT1 (MT), FPC2.MT2 (MT), R6.1, R7.1, R11.2, R36.1, R40.1, U3.2 (GND), U6.2 (GND), U11.9 (!CE), U11.17 (PGND), U11.18 (PGND), U11.25 (PGND), U$3.GND, U$3.SH1 (SHIELD), U$3.SH2 (SHIELD), U$3.SH3 (SHIELD), U$3.SH4 (SHIELD), U$3.SH5 (SHIELD), U$3.SH6 (SHIELD), U$3.SH7 (SHIELD), U$3.SH8 (SHIELD); also elsewhere on the board
I2C_SCL: U11.5 (SCL); also elsewhere on the board
I2C_SDA: U11.6 (SDA); also elsewhere on the board
LCD_B2: FPC2.17; also elsewhere on the board
LCD_B3: FPC2.16; also elsewhere on the board
LCD_B4: FPC2.15; also elsewhere on the board
LCD_B5: FPC2.14; also elsewhere on the board
LCD_B6: FPC2.13; also elsewhere on the board
LCD_B7: FPC2.12; also elsewhere on the board
LCD_BACKLIGHT_EN: U3.4 (CTRL); also elsewhere on the board
LCD_CLK: FPC2.37; also elsewhere on the board
LCD_CS: FPC2.3; also elsewhere on the board
LCD_DE: FPC2.8; also elsewhere on the board
LCD_G2: FPC2.25; also elsewhere on the board
LCD_G3: FPC2.24; also elsewhere on the board
LCD_G4: FPC2.23; also elsewhere on the board
LCD_G5: FPC2.22; also elsewhere on the board
LCD_G6: FPC2.21; also elsewhere on the board
LCD_G7: FPC2.20; also elsewhere on the board
LCD_HSYNC: FPC2.10; also elsewhere on the board
LCD_R2: FPC2.33; also elsewhere on the board
LCD_R3: FPC2.32; also elsewhere on the board
LCD_R4: FPC2.31; also elsewhere on the board
LCD_R5: FPC2.30; also elsewhere on the board
LCD_R6: FPC2.29; also elsewhere on the board
LCD_R7: FPC2.28; also elsewhere on the board
LCD_RESET: FPC2.6; also elsewhere on the board
LCD_SPI_MOSI: FPC2.4; also elsewhere on the board
LCD_SPI_SCLK: FPC2.5; also elsewhere on the board
LCD_VSYNC: FPC2.9; also elsewhere on the board
LEDA: C27.1, D2.C, FPC2.39, R8.2
LEDK: FPC2.40, R7.2, U3.3 (FB)
LED_CHG_BLUE: R2.1; also elsewhere on the board
LED_CHG_GREEN: R3.1; also elsewhere on the board
LED_CHG_RED: R39.2; also elsewhere on the board
unnamed: D2.A, L2.2, U3.1 (SW)
unnamed: R2.2, RGB1.3 (BC)
unnamed: R3.2, RGB1.4 (GC)
unnamed: R39.1, RGB1.1 (RC)
unnamed: R6.2, R8.1, U3.5 (OVP)
unnamed: R40.2, U11.10 (ILIM)
unnamed: C40.2, U11.21 (BTST)
unnamed: BAT_THERM.2, R36.2, R37.1, U11.11 (TS)
unnamed: C40.1, L1.1, U11.19 (SW), U11.20 (SW)
unnamed: C12.1, C37.1, SJ1.1, U11.23 (PMID)
REGN: C43.1, R37.2, U11.22 (REGN)
SWHOME: U11.12 (QON); also elsewhere on the board
USB_5V: C39.1, SJ1.2, U11.1 (VBUS), U11.24 (VBUS), U$3.VBUS; also elsewhere on the board
USB_DM: U11.3 (D-), U$3.DM; also elsewhere on the board
USB_DP: U11.2 (D+), U$3.DP; also elsewhere on the board
USB_ID: U$3.ID; also elsewhere on the board
VBAT: C44.1, CN1.1 (2), R10.1, U11.13 (BAT), U11.14 (BAT); also elsewhere on the board
VCC: C22.1, C28.1, C41.1, C42.1, L1.2, L2.1, U3.6 (VIN), U6.1 (IN), U6.3 (EN), U11.8 (OTG), U11.15 (SYS), U11.16 (SYS); also elsewhere on the board

Notes on the sheet:
3.5" LCD connector
Driver: ST7272A Backlight: 6S1P, 19.2V, 15mA typ
typ 15mA, typ 19.2V 0.2V / 0.0146A = 13.7 ohm Resistor power: 0.2V*0.015A = 3mW
3.5" LCD backlight driver
Battery Charger and Power Path Management USB and Lipo connectors
Max input current = (1V/Rilim) * 435 390R results in a 1.1A max input current. 1.1A/3.7V*5V*0.9A-0.2A = average charge current would be 1.1A
DB0 6
DB23 29

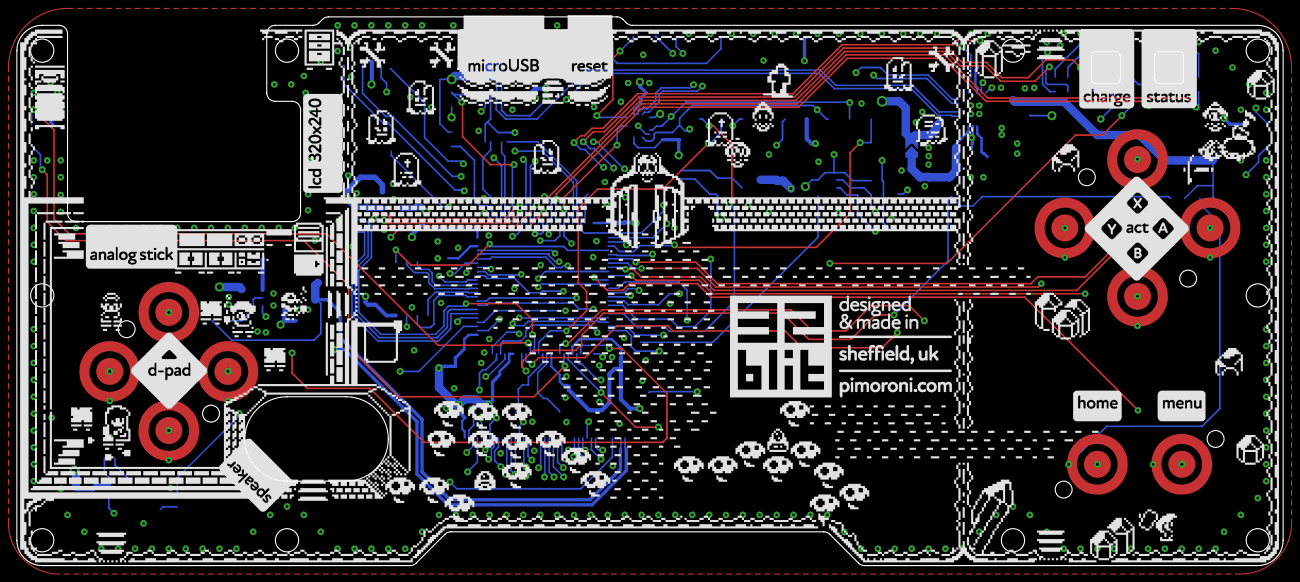
[picture p11: board 32blit.brd from above]

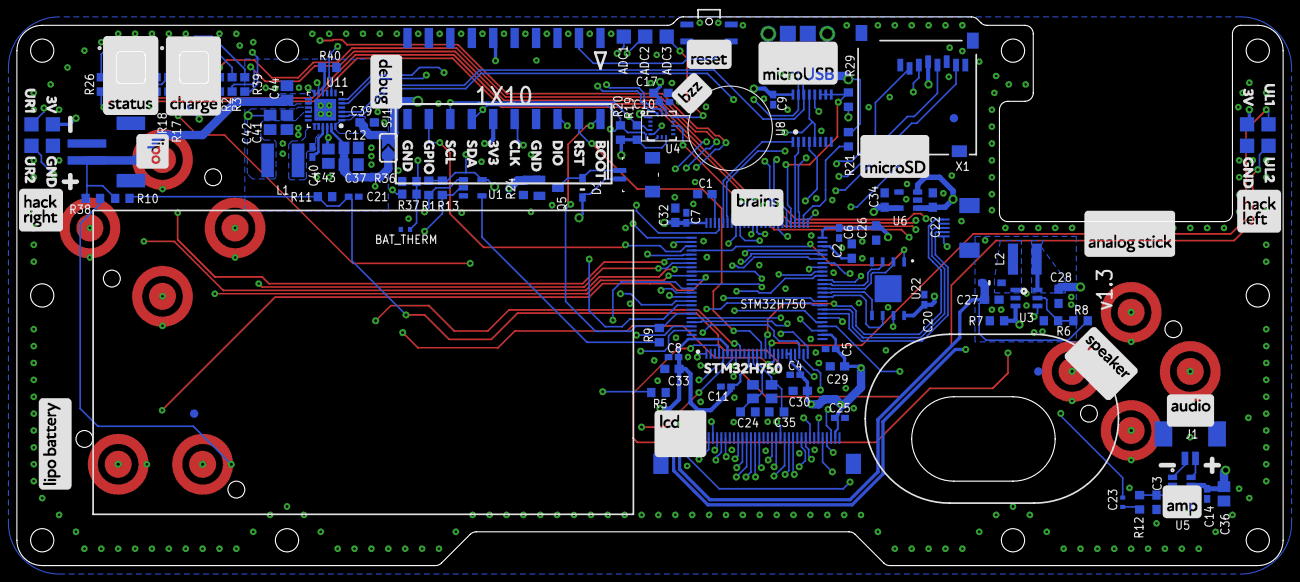
[picture p12: board 32blit.brd from below]

Board: 4 copper layers, 150.0 x 65.0 mm, 121 parts (106 on the bottom side), 117 nets.

Other parts of the board:
U$2: LRA_ELV1030AC1
U$6, U$8, U$9, U$10, U$11, U$12, U$13, U$14, U$16, U$20: 2.7MM-MOUNTING-HOLE
U$7: LCD_035
U$15: 3020_SPEAKER
U$21: JOYSTICK_ANALOG
