32blit/32blit-hardware/STM32H750VBTx.ioc

Mcu.UserName=STM32H750VBTx
PA0.GPIO_Label=LCD_CS
PA0.Signal=GPIO_Output
PA1.Signal=LTDC_R2
PA11.GPIO_Label=USB_DFU_DM / LTDC_R4
PA11.Signal=LTDC_R4
PA12.GPIO_Label=USB_DFU_DP
PA12.Signal=GPIO_Input
PA2.GPIO_Label=LCD_RESET
PA2.Signal=GPIO_Output
PA3.Signal=LTDC_B5
PA4.Signal=LTDC_VSYNC
PA5.Signal=COMP_DAC12_group
PA6.Signal=LTDC_G2
PA7.GPIO_Label=SD_SPI1_MOSI
PA7.Signal=SPI1_MOSI
PA8.Signal=LTDC_B3
PA9.Signal=LTDC_R5
PB0.Signal=LTDC_R3
PB1.Signal=LTDC_R6
PB10.Signal=LTDC_G4
PB11.Signal=LTDC_G5
PB12.Signal=USB_OTG_HS_ID
PB13.Signal=USB_OTG_HS_VBUS
PB14.Signal=USB_OTG_HS_DM
PB15.Signal=USB_OTG_HS_DP
PB2.Signal=QUADSPI_CLK
PB5.GPIO_Label=LED_BLUE
PB5.Signal=S_TIM3_CH2
PB6.GPIO_Label=VIBE_EN
PB6.Signal=S_TIM4_CH1
PB8.Signal=LTDC_B6
PB9.Signal=LTDC_B7
PC0.GPIO_Label=JOYSTICK_Y
PC0.Signal=ADCx_INP10
PC1.GPIO_Label=USER_LEFT1
PC1.Signal=ADCx_INP11
PC10.GPIO_Label=EXTENSION_GPIO
PC10.Signal=GPIO_Input
PC11.Signal=QUADSPI_BK2_NCS
PC13.GPIO_Label=AMP_SHUTDOWN
PC13.Signal=GPIO_Output
PC2_C.GPIO_Label=USER_RIGHT1
PC2_C.Signal=ADC3_INP0
PC3_C.GPIO_Label=BATTERY_SENSE
PC3_C.Signal=ADC3_INP1
PC4.GPIO_Label=JOYSTICK_X
PC4.Signal=ADCx_INP4
PC5.GPIO_Label=JOYSTICK_BUTTON
PC5.Signal=GPIO_Input
PC6.Signal=LTDC_HSYNC
PC7.Signal=LTDC_G6
PC8.GPIO_Label=LED_RED
PC8.Signal=S_TIM3_CH3
PC9.GPIO_Label=LED_GREEN
PC9.Signal=S_TIM3_CH4
PD0.GPIO_Label=BUTTON_X
PD0.Signal=GPIO_Input
PD1.GPIO_Label=BUTTON_Y
PD1.Signal=GPIO_Input
PD10.GPIO_Label=DPAD_LEFT
PD10.Signal=GPIO_Input
PD11.GPIO_Label=SD_DETECT
PD11.Signal=GPIO_Input
PD12.Signal=I2C4_SCL
PD13.Signal=I2C4_SDA
PD14.GPIO_Label=DPAD_DOWN
PD14.Signal=GPIO_Input
PD15.GPIO_Label=DPAD_RIGHT
PD15.Signal=GPIO_Input
PD2.GPIO_Label=BUTTON_A
PD2.Signal=GPIO_Input
PD3.Signal=LTDC_G7
PD4.GPIO_Label=BUTTON_B
PD4.Signal=GPIO_Input
PD5.GPIO_Label=BUTTON_MENU
PD5.Signal=GPIO_Input
PD6.Signal=LTDC_B2
PD7.GPIO_Label=BUTTON_HOME
PD7.Signal=GPIO_Input
PD8.GPIO_Label=USB_SWAP
PD8.Signal=GPIO_Output
PD9.GPIO_Label=DPAD_UP
PD9.Signal=GPIO_Input
PE10.Signal=QUADSPI_BK2_IO3
PE11.Signal=LTDC_G3
PE12.Signal=LTDC_B4
PE13.Signal=LTDC_DE
PE14.Signal=LTDC_CLK
PE15.Signal=LTDC_R7
PE2.GPIO_Label=LCD_SPI4_SCK
PE2.Signal=SPI4_SCK
PE5.GPIO_Label=LCD_BACKLIGHT_EN
PE5.Signal=S_TIM15_CH1
PE6.GPIO_Label=LCD_SPI4_MOSI
PE6.Signal=SPI4_MOSI
PE7.Signal=QUADSPI_BK2_IO0
PE8.Signal=QUADSPI_BK2_IO1
PE9.Signal=QUADSPI_BK2_IO2
