32blit/32blit-hardware/(commit log)

2021-05-21 Add BOM
    [bill-of-materials.csv]
2023-02-23 Add mechanical design files.
    [32blit.iam, action-button.ipt, action-button.stp, base.ipt, base.stp, dpad.ipt, pcb.ipt, system-buttons.ipt]
2023-02-23 Add PCB.
    [32blit.brd, 32blit.sch]
2023-03-01 Sync CubeMX IOC project file with final hardware
    Final hardware uses a 12MHz crystal on HSE. Dividers are synced to
    match those used in the firmware. I have also checked all GPIO
    functions against the PDF schematic and firmware.
    Note that some very early pre-beta boards use different crystals.
2023-03-01 Delete the duplicate Eagle schematic in root
    It was identical to the one recently added to pcb subdirectory.
    [32blit.sch]
